wonkystuff/miniMO_core/Programs/README.md

# Building the Programs

These should work with the following settings:

* Arduino IDE 1.8.19
* ATTinyCore library -- select ATTiny25/45/85 (no bootloader)
* millis()/micros() disabled

Something like this:
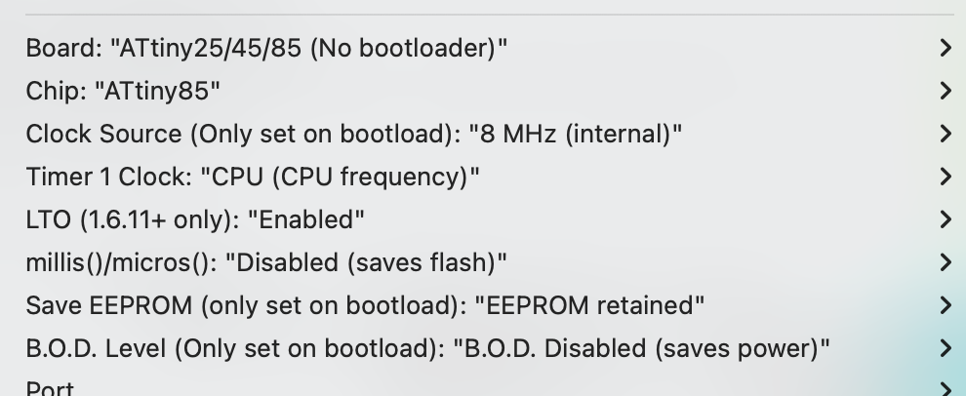
[picture p2: Programs/toolmenu.png]
Tools Menu
