wonkystuff/miniMO_core/BOM_and_schematic/Gerber_wonkystuff/PCB_minimo_top.png

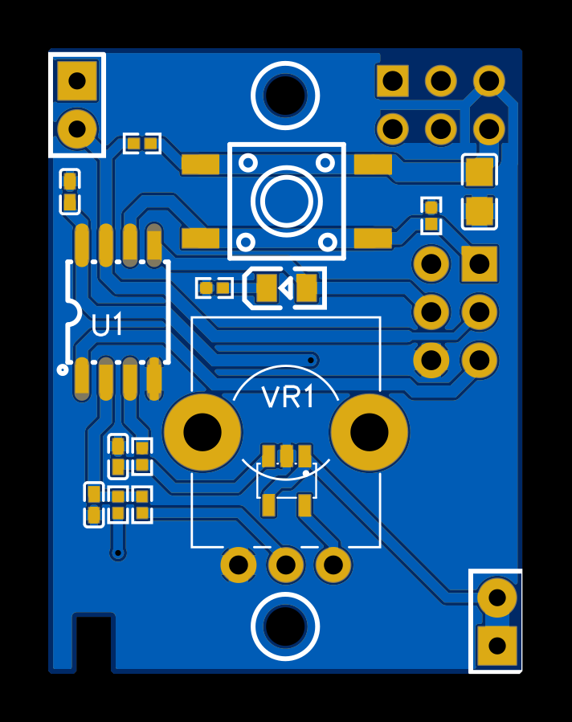
BOM_and_schematic/Gerber_wonkystuff/PCB_minimo_top.png
