wonkystuff/miniMO_core/BOM_and_schematic/miniMO_schem_wonkystuff.png

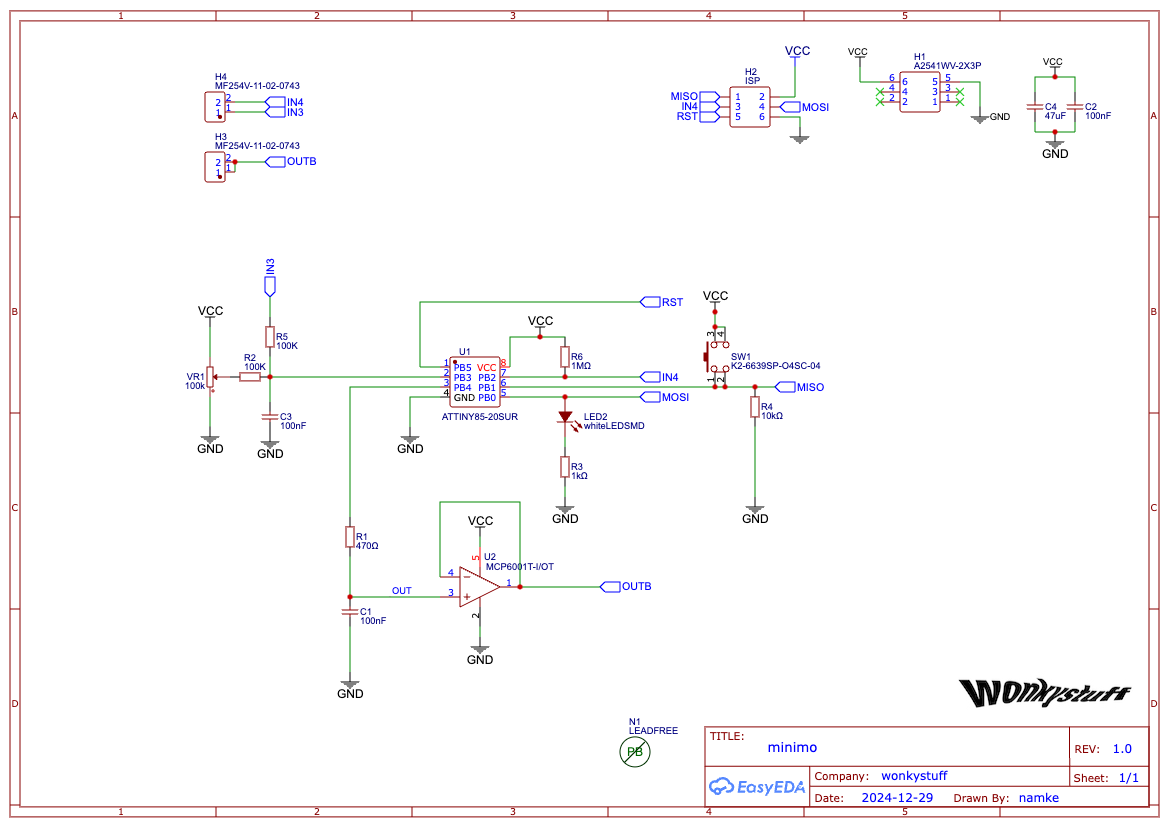
BOM_and_schematic/miniMO_schem_wonkystuff.png
