wonkystuff/miniMO_core/BOM_and_schematic/3DModel/PCB_minimo_1-0.obj

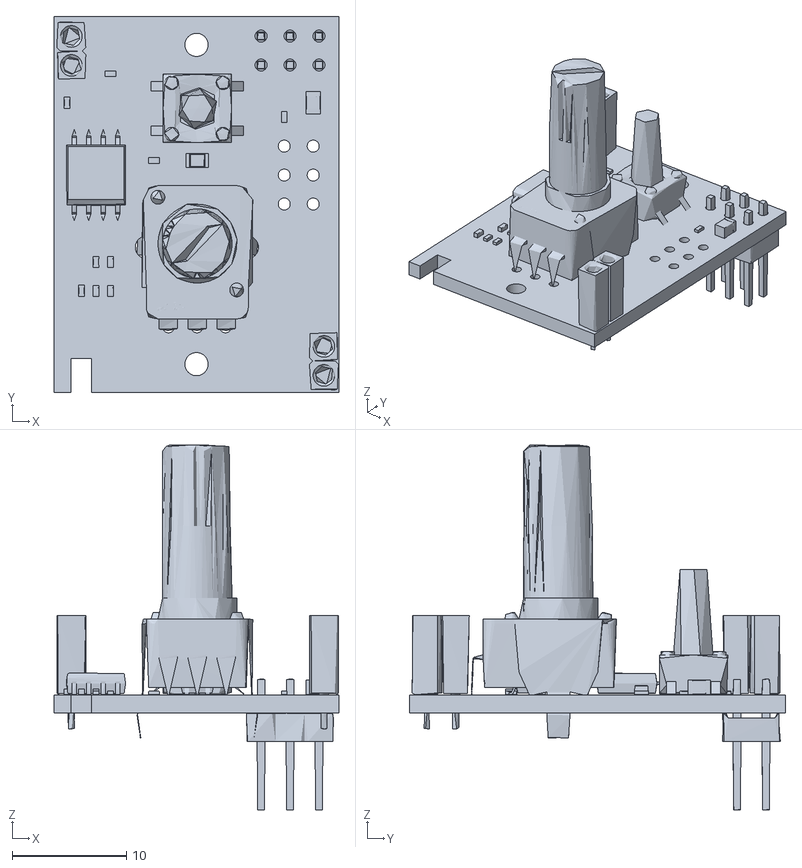
[picture p6: CAD file, 2024-12-30]
BOM_and_schematic/3DModel/PCB_minimo_1-0.obj
25.0 x 33.0 x 32.0
