wonkystuff/miniMO_core/(commit log)

2024-12-29 Delete 3D_parts directory
    This isn't needed for what I have in mind, so I'm just tidying up :)
    [2_part_case_down_base.stl, 2_part_case_down_base_for_flexible_cover.stl, 2_part_case_down_cover.stl, 2_part_case_up_base.stl, 2_part_case_up_base_for_flexible_cover.stl, 2_part_case_up_cover.stl, battery_holder.stl, battery_lid.stl]
2024-12-29 Added 'AE Modular' schematic
    I don't even know if this will work…!
2024-12-29 Delete BOM_and_schematic/BOM_3Dprinted_model.txt
    Going to replace with my BOM
2024-12-29 Delete BOM_and_schematic/BOM_PCB_model.txt
    Going to commit my BOM
2024-12-29 Delete BOM_and_schematic/miniMO_breadboard.fzz
    Not relevant here
    [miniMO_breadboard.fzz]
2024-12-29 Adding JLCPCB BOM
    First cut…
    [BOM_minimo.csv]
2024-12-29 Update BOM_minimo.csv
    Small tidying of Chinese characters
    [BOM_minimo.csv]
2024-12-29 Update BOM_minimo.csv
    Removed quotation marks
    [BOM_minimo.csv]
2024-12-29 Delete BOM_and_schematic/BOM_minimo.csv
    Messed up the BOM
    [BOM_minimo.csv]
2024-12-29 New BOM
    [BOM_minimo.csv]
2024-12-30 Added v1.0 Gerber files as sent for production (UNTESTEDgit add Gerber_wonkystuff/)
2024-12-30 Added PNG of board top & bottom
2024-12-30 Updated for use with Arduino IDE 1.8.19 - all seen to build (not run yet)
2024-12-30 Quick aide-memoire regarding Arduino settings.
2024-12-30 What happens with the exported 3D model from EasyEDA?
    [OBJ_PCB_minimo.obj]
2024-12-30 Added better 3D OBJ model
    [OBJ_PCB_minimo.obj, PCB_minimo_1-0.obj]
2024-12-30 Added material file
    [PCB_minimo_1-0.obj]
2024-12-31 Moved 3D model files to their own directory
    [PCB_minimo_1-0.obj]
2025-02-16 Removed duplicate 3d model files
    [PCB_minimo_1-0.obj]
2025-02-16 Button press handler no longer cuts the sound out. (Not massively tested!)
    [Algorithmic_Generator.ino]
